willg/adaSMU/readme.md

AdaSMU
======

This repository tracks the design of a source measurment unit (SMU).  

There is a detailed description of the project in this repository here:
[link](https://github.com/willg/adaSMU/blob/master/updates/update1.md)

The GNAT project isn't currently in this repository.  It can be found here: [link](http://github.com/willg/AdaSMU-AdaDriverLibrary/blob/willgExperiments/examples/hello_world_blinky/blinky_f429disco.gpr)
