willg/adaSMU/(commit log)

2016-09-28 initial commit from Driver Library Example repo -- tasking working
2016-09-29 added function to dacControl to generate the correct dac code given the desired output voltage
2016-09-29 added variable to dacControl package to allow outside tasks to set the output voltage
2016-09-29 dacControl working as a function instead of a task. I thought the problem with DAC&LCD running at the same time was some kind of task conflict, but it was an IO conflict between DAC output1 and the L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
2016-09-30 switched back to dacTask, fixed dacoutput
2016-09-30 calibrated slope and intercept used to in DacCodeFromVoltage
2016-09-30 updated UI, sped up task to make button more responsive
2016-09-30 added kicad schematics
    [adaSMU.kicad_pcb, adaSMU.sch, offsetAndScale.sch, outputDriver.sch]
